tuton-RCJ/RCJ2026PCB/README.md

# RCJ2026PCB
PCBs for RoboCupJunior 2026 Maze
