tuton-RCJ/RCJ2026PCB/01-kanto/02-BOTTOM/02-BOTTOM.step

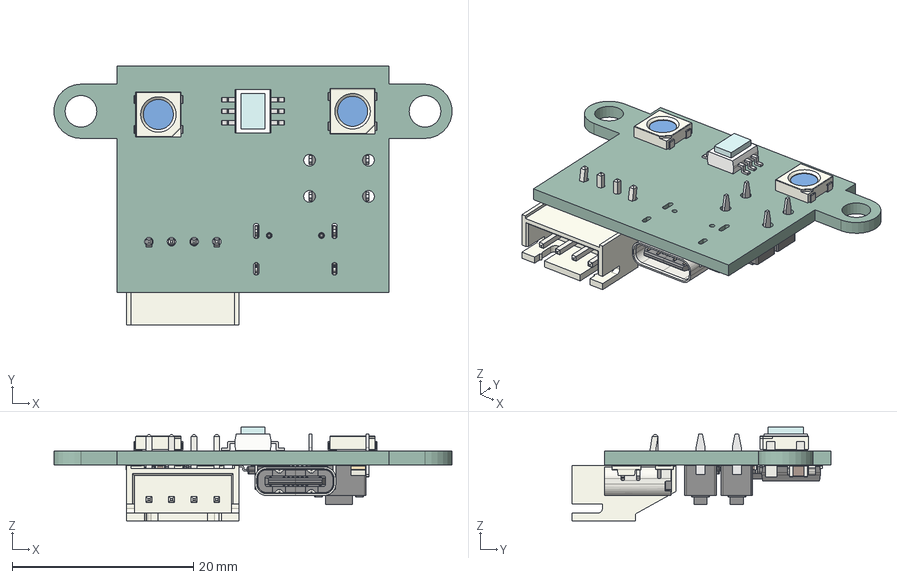
[picture p1: CAD file, 2025-10-03]
01-kanto/02-BOTTOM/02-BOTTOM.step
44.0 x 28.6 x 10.3 mm
LED_WS2812B_PLCC4_5.0x5.0mm_P3.2mm x 2
S9706 v1 v1
LQFP-48_7x7mm_P0.5mm
C_0402_1005Metric x 8
R_0805_2012Metric x 4
R_0402_1005Metric x 4
C_0805_2012Metric x 2
TVBP06_SW v2 x 2
MSOP-10_3x3mm_P0.5mm
C_0603_1608Metric
LED_1206_3216Metric x 2
JST_XH_S4B-XH-A_1x04_P2.50mm_Horizontal
USB_C_Receptacle_GCT_USB4105-xx-A_16P_TopMnt_Horizontal
SOT-223
02-BOTTOM_PCB
