tuton-RCJ/RCJ2026PCB/01-kanto/04-RPi/04-RPi.step

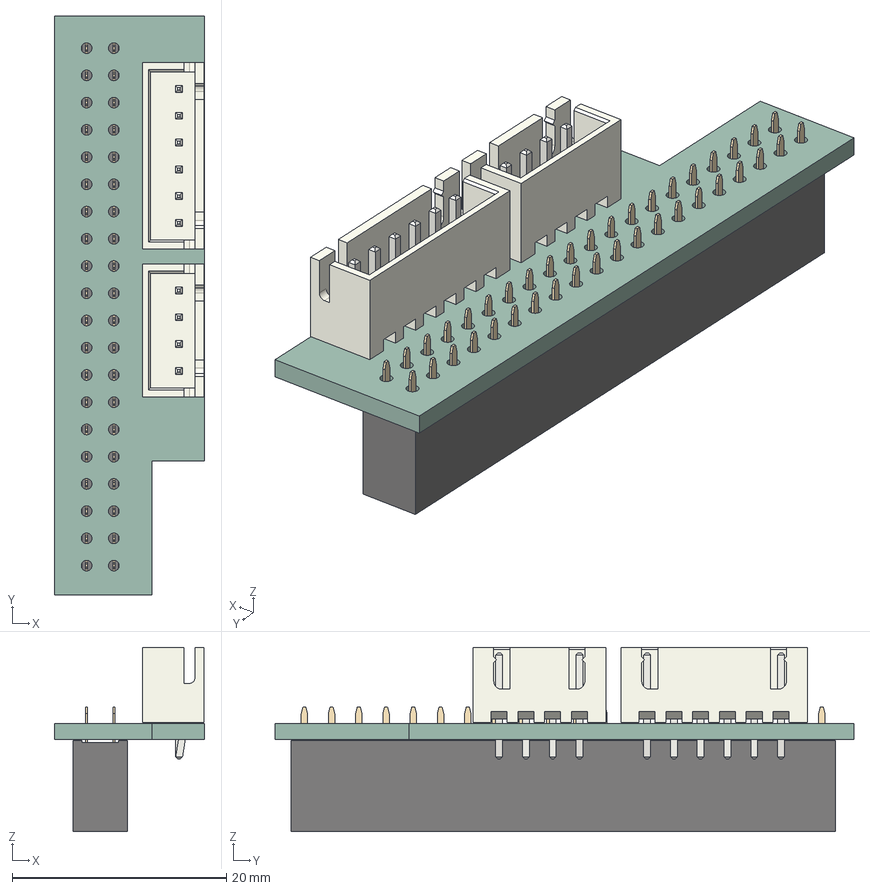
[picture p2: CAD file, 2025-10-18]
01-kanto/04-RPi/04-RPi.step
14.0 x 54.0 x 17.2 mm
JST_XH_B6B-XH-A_1x06_P2.50mm_Vertical
JST_XH_B4B-XH-A_1x04_P2.50mm_Vertical
PinSocket_2x20_P2.54mm_Vertical
04-RPi_PCB
