tuton-RCJ/RCJ2026PCB/01-kanto/04-RPi/04-RPi.kicad_pcb

## KiCad design 01-kanto/04-RPi/04-RPi.kicad_pcb (2025-10-18)

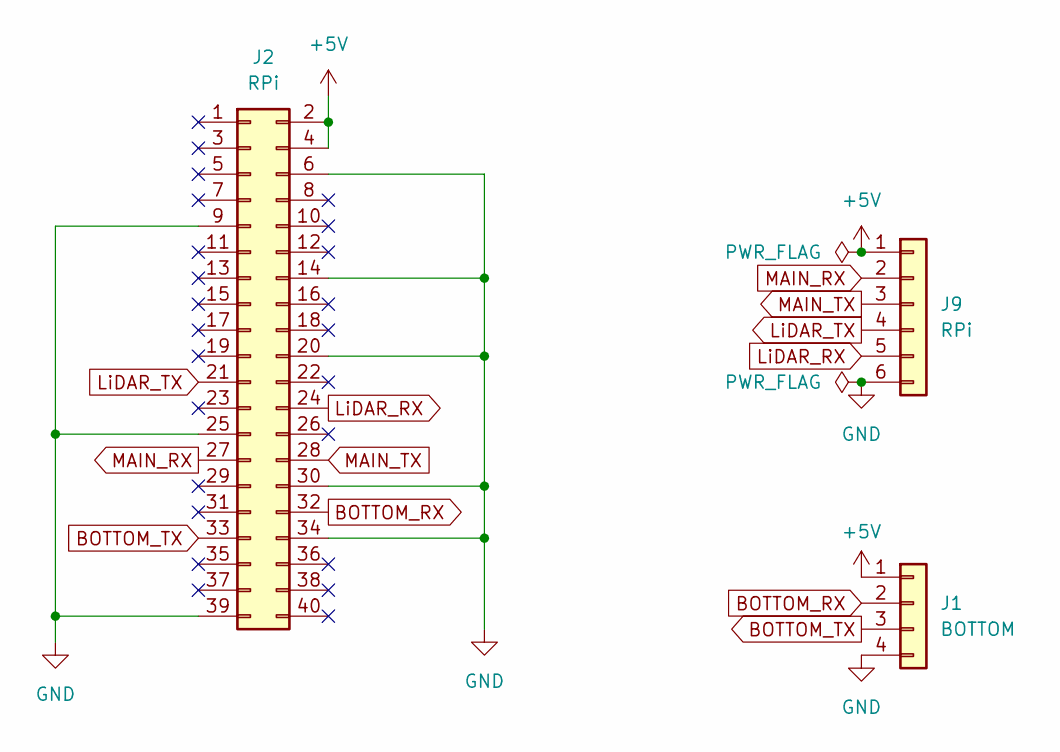
[picture p3: schematic 04-RPi.kicad_sch]

Parts:
J1: BOTTOM; JST_XH_B4B-XH-A_1x04_P2.50mm_Vertical
J2: RPi; PinSocket_2x20_P2.54mm_Vertical
J9: RPi; JST_XH_B6B-XH-A_1x06_P2.50mm_Vertical

Connections:
+5V: J1.1, J2.2, J2.4, J9.1
BOTTOM_RX: J1.2, J2.32
BOTTOM_TX: J1.3, J2.33
GND: J1.4, J2.6, J2.9, J2.14, J2.20, J2.25, J2.30, J2.34, J2.39, J9.6
LiDAR_RX: J2.24, J9.5
LiDAR_TX: J2.21, J9.4
MAIN_RX: J2.27, J9.2
MAIN_TX: J2.28, J9.3

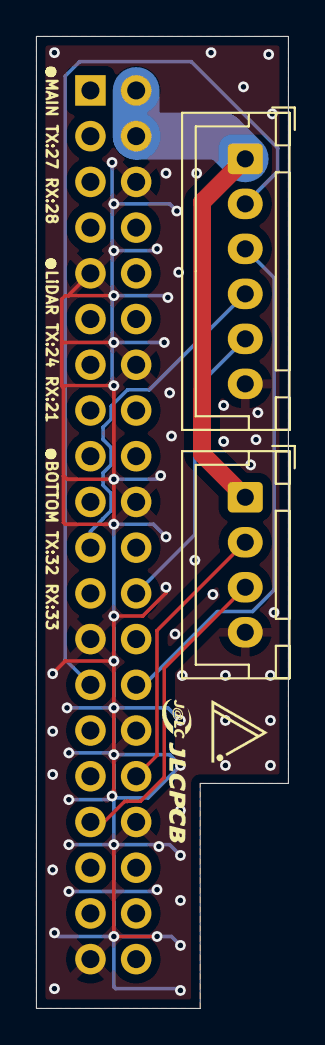
[picture p4: board 04-RPi.kicad_pcb from above]

Board: 2 copper layers, 14.0 x 54.0 mm, 3 parts (1 on the bottom side), 8 nets.
