tuton-RCJ/RCJ2026PCB/01-kanto/01-MAIN/01-MAIN.kicad_pcb

## KiCad design 01-kanto/01-MAIN/01-MAIN.kicad_pcb (2025-10-18)

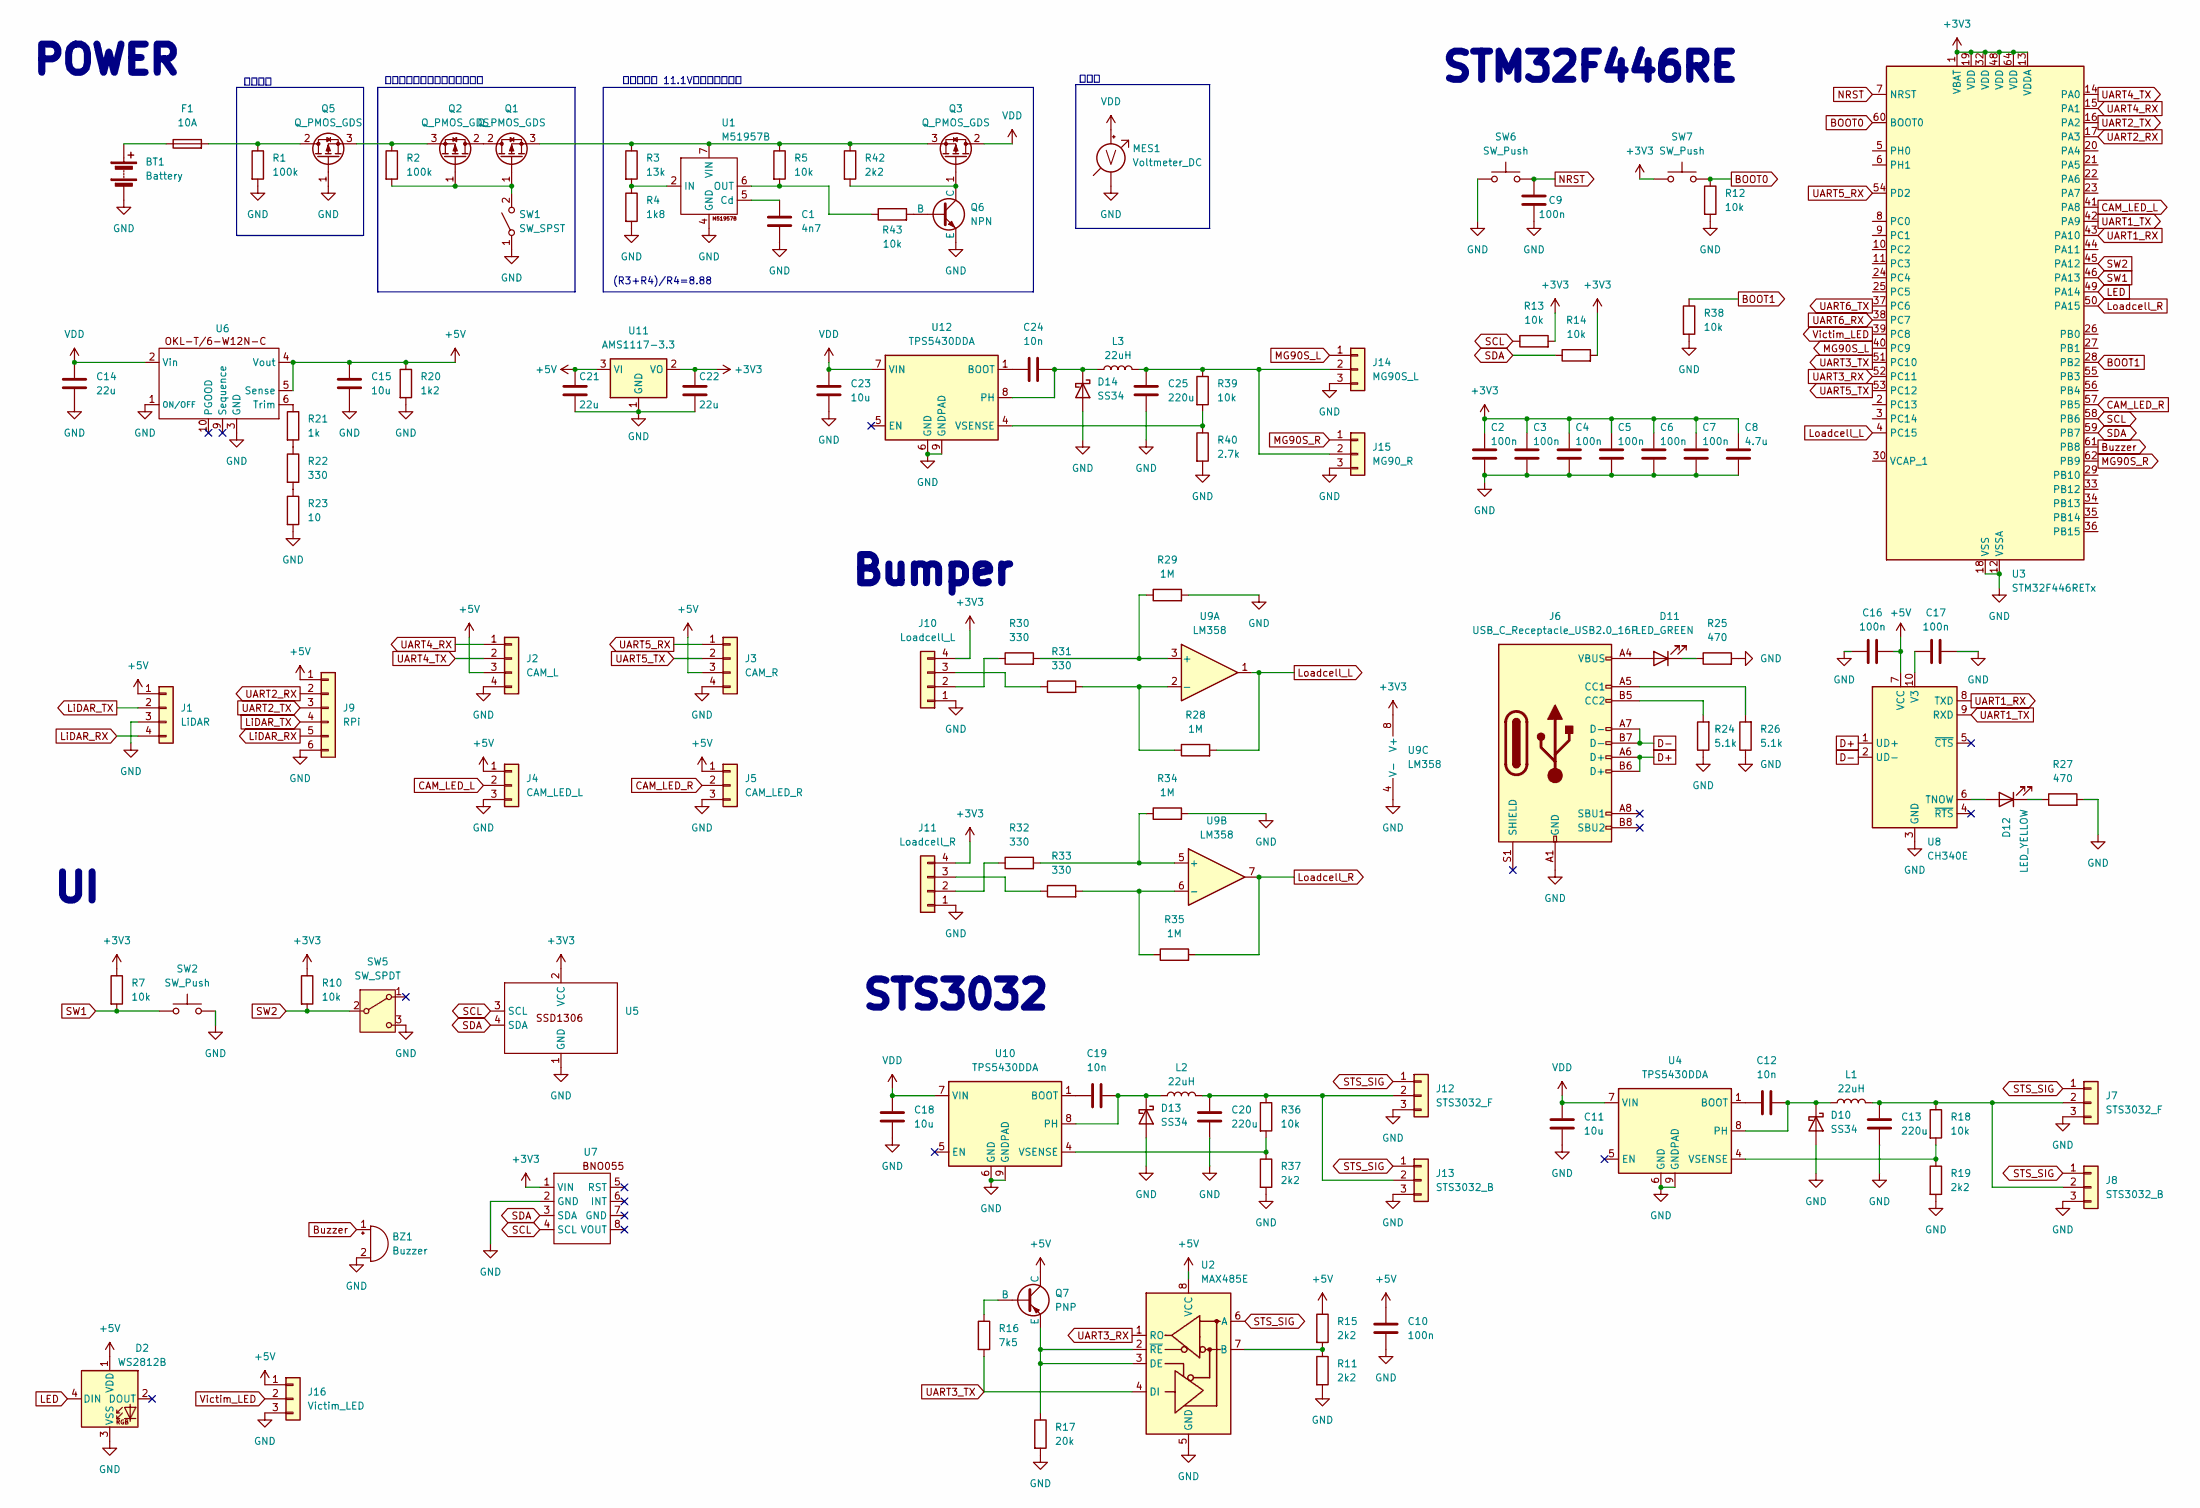
[picture p5: schematic 01-MAIN.kicad_sch]

Parts:
BT1: Battery; SolderWire-0.75sqmm_1x02_P7mm_D1.25mm_OD3.5mm
BZ1: Buzzer; Buzzer_TDK_PS1240P02BT_D12.2mm_H6.5mm
C1: 4n7; C_0402_1005Metric; LCSC C1538
C2, C3, C4, C5, C6, C7, C9, C10, C16, C17: 100n; C_0402_1005Metric; LCSC C1525
C8: 4.7u; C_0402_1005Metric; LCSC C23733
C11, C15, C18, C23: 10u; C_0805_2012Metric; LCSC C15850
C12, C19, C24: 10n; C_0402_1005Metric; LCSC C15195
C13, C20, C25: 220u; CP_Radial_D6.3mm_P2.50mm
C14, C21, C22: 22u; C_0805_2012Metric; LCSC C45783
D2: WS2812B; LED_WS2812B_PLCC4_5.0x5.0mm_P3.2mm
D10, D13, D14: SS34; D_SMA; LCSC C8678
D11: LED_GREEN; LED_0805_2012Metric; LCSC C2297
D12: LED_YELLOW; LED_0805_2012Metric; LCSC C2296
F1: 10A; FUSE_3557-15
J1: LiDAR; JST_PH_S4B-PH-K_1x04_P2.00mm_Horizontal
J2: CAM_L; Grove_1x04
J3: CAM_R; Grove_1x04
J4: CAM_LED_L; JST_PH_S3B-PH-K_1x03_P2.00mm_Horizontal
J5: CAM_LED_R; JST_PH_S3B-PH-K_1x03_P2.00mm_Horizontal
J6: USB_C_Receptacle_USB2.0_16P; USB_C_Receptacle_GCT_USB4105-xx-A_16P_TopMnt_Horizontal; LCSC C2765186
J7, J12: STS3032_F; Molex_SPOX_5268-03A_1x03_P2.50mm_Horizontal
J8, J13: STS3032_B; Molex_SPOX_5268-03A_1x03_P2.50mm_Horizontal
J9: RPi; JST_XH_B6B-XH-A_1x06_P2.50mm_Vertical
J10: Loadcell_L; JST_PH_S4B-PH-K_1x04_P2.00mm_Horizontal
J11: Loadcell_R; JST_PH_S4B-PH-K_1x04_P2.00mm_Horizontal
J14: MG90S_L; PinHeader_1x03_P2.54mm_Horizontal
J15: MG90_R; PinHeader_1x03_P2.54mm_Horizontal
J16: Victim_LED; JST_XH_B3B-XH-A_1x03_P2.50mm_Vertical
L1, L2, L3: 22uH; FXL1040-220-M; LCSC C177244
MES1: Voltmeter_DC; JST_XH_B2B-XH-A_1x02_P2.50mm_Vertical
Q1, Q2, Q3, Q5: Q_PMOS_GDS; TO-251-3_Vertical
Q6: NPN; SOT-23; LCSC C7420356
Q7: PNP; SOT-23; LCSC C41375129
R1, R2: 100k; R_0402_1005Metric; LCSC C25741
R3: 13k; R_0603_1608Metric; LCSC C22797
R4: 1k8; R_0603_1608Metric; LCSC C4177
R5, R7, R10, R12, R13, R14, R18, R36, R38, R39, R43: 10k; R_0402_1005Metric; LCSC C25744
R11, R15, R19, R37, R42: 2k2; R_0402_1005Metric; LCSC C25879
R16: 7k5; R_0603_1608Metric; LCSC C23234
R17: 20k; R_0402_1005Metric; LCSC C25765
R20: 1k2; R_0603_1608Metric; LCSC C22765
R21: 1k; R_0402_1005Metric; LCSC C11702
R22, R30, R31, R32, R33: 330; R_0402_1005Metric; LCSC C25104
R23: 10; R_0402_1005Metric; LCSC C25077
R24, R26: 5.1k; R_0402_1005Metric; LCSC C25905
R25, R27: 470; R_0603_1608Metric; LCSC C23179
R28, R29, R34, R35: 1M; R_0402_1005Metric; LCSC C26083
R40: 2.7k; R_0603_1608Metric; LCSC C13167
SW1: SW_SPST; AkizukiSmallRockerSwitchHorizontal
SW2, SW6, SW7: SW_Push; SW_PUSH_6mm
SW5: SW_SPDT; Akizuki_3PSW
U1: M51957B
U2: MAX485E; SOIC-8_3.9x4.9mm_P1.27mm
U3: STM32F446RETx; LQFP-64_10x10mm_P0.5mm
U4, U10, U12: TPS5430DDA; TI_SO-PowerPAD-8_ThermalVias; LCSC C9864
U5: SSD1306
U6: OKL-T/6-W12N-C; OKL-T6-W12N-C-SMD
U7: BNO055
U8: CH340E; MSOP-10_3x3mm_P0.5mm; LCSC C99652
U9: LM358; SOIC-8-1EP_3.9x4.9mm_P1.27mm_EP2.29x3mm; LCSC C7950
U11: AMS1117-3.3; SOT-223-3_TabPin2; LCSC C6186

Connections:
+3V3: C2.1, C3.1, C4.1, C5.1, C6.1, C7.1, C8.1, C22.1, J10.4, J11.4, R7.1, R10.1, R13.2, R14.2, SW7.1, U3.1 (VBAT), U3.13 (VDDA), U3.19 (VDD), U3.32 (VDD), U3.48 (VDD), U3.64 (VDD), U5.2 (VCC), U7.1 (VIN), U9.8 (V+), U11.2 (VO)
+5V: C10.2, C15.1, C16.2, C21.1, D2.1 (VDD), J1.1, J2.3, J3.3, J4.1, J5.1, J9.1, J16.1, Q7.1 (C), R15.1, R20.1, U2.8 (VCC), U6.4 (Vout), U6.5 (Sense), U8.7 (VCC), U11.3 (VI)
BOOT0: R12.1, SW7.2, U3.60 (BOOT0)
BOOT1: R38.1, U3.28 (PB2)
Buzzer: BZ1.1 (+), U3.61 (PB8)
CAM_LED_L: J4.2, U3.41 (PA8)
CAM_LED_R: J5.2, U3.57 (PB5)
D+: J6.A6 (D+), J6.B6 (D+), U8.1 (UD+)
D-: J6.A7 (D-), J6.B7 (D-), U8.2 (UD-)
GND: BT1.2 (-), BZ1.2 (-), C1.2, C2.2, C3.2, C4.2, C5.2, C6.2, C7.2, C8.2, C9.2, C10.1, C11.2, C13.2, C14.2, C15.2, C16.1, C17.2, C18.2, C20.2, C21.2, C22.2, C23.2, C25.2, D2.3 (VSS), D10.2 (A), D13.2 (A), D14.2 (A), J1.3, J2.4, J3.4, J4.3, J5.3, J6.A1 (GND), J6.A12 (GND), J6.B1 (GND), J6.B12 (GND), J7.3, J8.3, J9.6, J10.1, J11.1, J12.3, J13.3, J14.3, J15.3, J16.3, MES1.1 (-), Q5.1 (G), Q6.3 (E), R1.2, R4.2, R11.2, R12.2, R17.2, R19.2, R20.2, R23.2, R24.1, R25.2, R26.1, R27.2, R29.2, R34.2, R37.2, R38.2, R40.2, SW1.1 (A), SW2.2, SW5.3 (C), SW6.1, U1.4 (GND), U2.5 (GND), U3.12 (VSSA), U3.18 (VSS), U3.31 (VSS), U3.47 (VSS), U3.63 (VSS), U4.6 (GND), U4.9 (GNDPAD), U5.1 (GND), U6.1 (ON/OFF), U6.3 (GND), U6.7 (GND), U7.2 (GND), U8.3 (GND), U9.4 (V-), U10.6 (GND), U10.9 (GNDPAD), U11.1 (GND), U12.6 (GND), U12.9 (GNDPAD)
LED: D2.4 (DIN), U3.49 (PA14)
LiDAR_RX: J1.4, J9.5
LiDAR_TX: J1.2, J9.4
Loadcell_L: R28.2, U3.4 (PC15), U9.1
Loadcell_R: R35.2, U3.50 (PA15), U9.7
MG90S_L: J14.1, U3.40 (PC9)
MG90S_R: J15.1, U3.62 (PB9)
NRST: C9.1, SW6.2, U3.7 (NRST)
unnamed: BT1.1 (+), F1.1
unnamed: C12.2, D10.1 (K), L1.1, U4.8 (PH)
unnamed: D11.2 (A), J6.A4 (VBUS), J6.A9 (VBUS), J6.B4 (VBUS), J6.B9 (VBUS)
unnamed: D11.1 (K), R25.1
unnamed: D12.2 (A), U8.6 (TNOW)
unnamed: D12.1 (K), R27.1
unnamed: C19.2, D13.1 (K), L2.1, U10.8 (PH)
unnamed: C24.2, D14.1 (K), L3.1, U12.8 (PH)
unnamed: J6.A5 (CC1), R26.2
unnamed: J6.B5 (CC2), R24.2
unnamed: C13.1, J7.2, J8.2, L1.2, R18.1
unnamed: J10.2, R30.1
unnamed: J10.3, R31.1
unnamed: J11.2, R32.1
unnamed: J11.3, R33.1
unnamed: C20.1, J12.2, J13.2, L2.2, R36.1
unnamed: C25.1, J14.2, J15.2, L3.2, R39.1
unnamed: Q1.2 (D), Q2.2 (D)
unnamed: Q1.1 (G), Q2.1 (G), R2.2, SW1.2 (B)
unnamed: Q1.3 (S), Q3.3 (S), R3.1, R5.1, R42.1, U1.7 (VIN)
unnamed: Q2.3 (S), Q5.3 (S), R2.1
unnamed: Q3.1 (G), Q6.1 (C), R42.2
unnamed: F1.2, Q5.2 (D), R1.1
unnamed: Q6.2 (B), R43.2
unnamed: Q7.2 (B), R16.1
unnamed: Q7.3 (E), R17.1, U2.2 (~RE), U2.3 (DE)
unnamed: R21.2, R22.1
unnamed: R22.2, R23.1
unnamed: C1.1, U1.5 (Cd)
unnamed: R3.2, R4.1, U1.2 (IN)
unnamed: R5.2, R43.1, U1.6 (OUT)
unnamed: R11.1, R15.2, U2.7 (B)
unnamed: C12.1, U4.1 (BOOT)
unnamed: R18.2, R19.1, U4.4 (VSENSE)
unnamed: R21.1, U6.6 (Trim)
unnamed: C17.1, U8.10 (V3)
unnamed: R29.1, R30.2, U9.3 (+)
unnamed: R28.1, R31.2, U9.2 (-)
unnamed: R32.2, R34.1, U9.5 (+)
unnamed: R33.2, R35.1, U9.6 (-)
unnamed: C19.1, U10.1 (BOOT)
unnamed: R36.2, R37.1, U10.4 (VSENSE)
unnamed: C24.1, U12.1 (BOOT)
unnamed: R39.2, R40.1, U12.4 (VSENSE)
SCL: R13.1, U3.58 (PB6), U5.3 (SCL), U7.4 (SCL)
SDA: R14.1, U3.59 (PB7), U5.4 (SDA), U7.3 (SDA)
STS_SIG: J7.1, J8.1, J12.1, J13.1, U2.6 (A)
SW1: R7.2, SW2.1, U3.46 (PA13)
SW2: R10.2, SW5.2 (B), U3.45 (PA12)
UART1_RX: U3.43 (PA10), U8.8 (TXD)
UART1_TX: U3.42 (PA9), U8.9 (RXD)
UART2_RX: J9.2, U3.17 (PA3)
UART2_TX: J9.3, U3.16 (PA2)
UART3_RX: U2.1 (RO), U3.52 (PC11)
UART3_TX: R16.2, U2.4 (DI), U3.51 (PC10)
UART4_RX: J2.1, U3.15 (PA1)
UART4_TX: J2.2, U3.14 (PA0)
UART5_RX: J3.1, U3.54 (PD2)
UART5_TX: J3.2, U3.53 (PC12)
UART6_RX: U3.38 (PC7)
UART6_TX: U3.37 (PC6)
VDD: C11.1, C14.1, C18.1, C23.1, MES1.2 (+), Q3.2 (D), U4.7 (VIN), U6.2 (Vin), U10.7 (VIN), U12.7 (VIN)
Victim_LED: J16.2, U3.39 (PC8)

Notes on the sheet:
POWER
STM32F446RE
ハイサイドスイッチ＆逆流保護
STS3032
(R3+R4)/R4=8.88
低電圧防止 11.1V以下で強制遮断
Bumper
電圧計
逆接保護

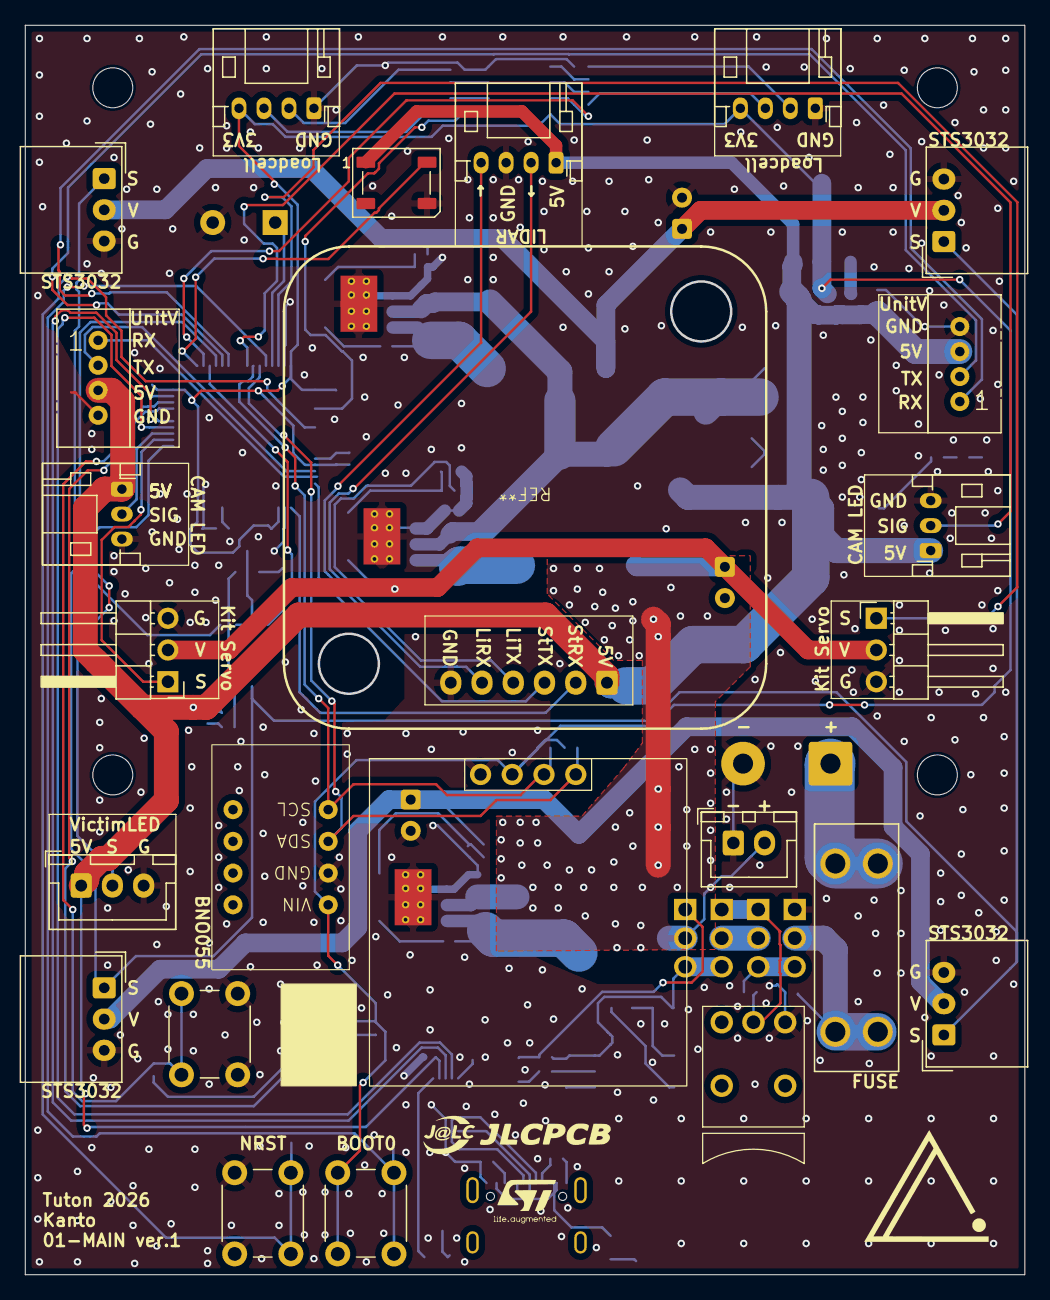
[picture p6: board 01-MAIN.kicad_pcb from above]

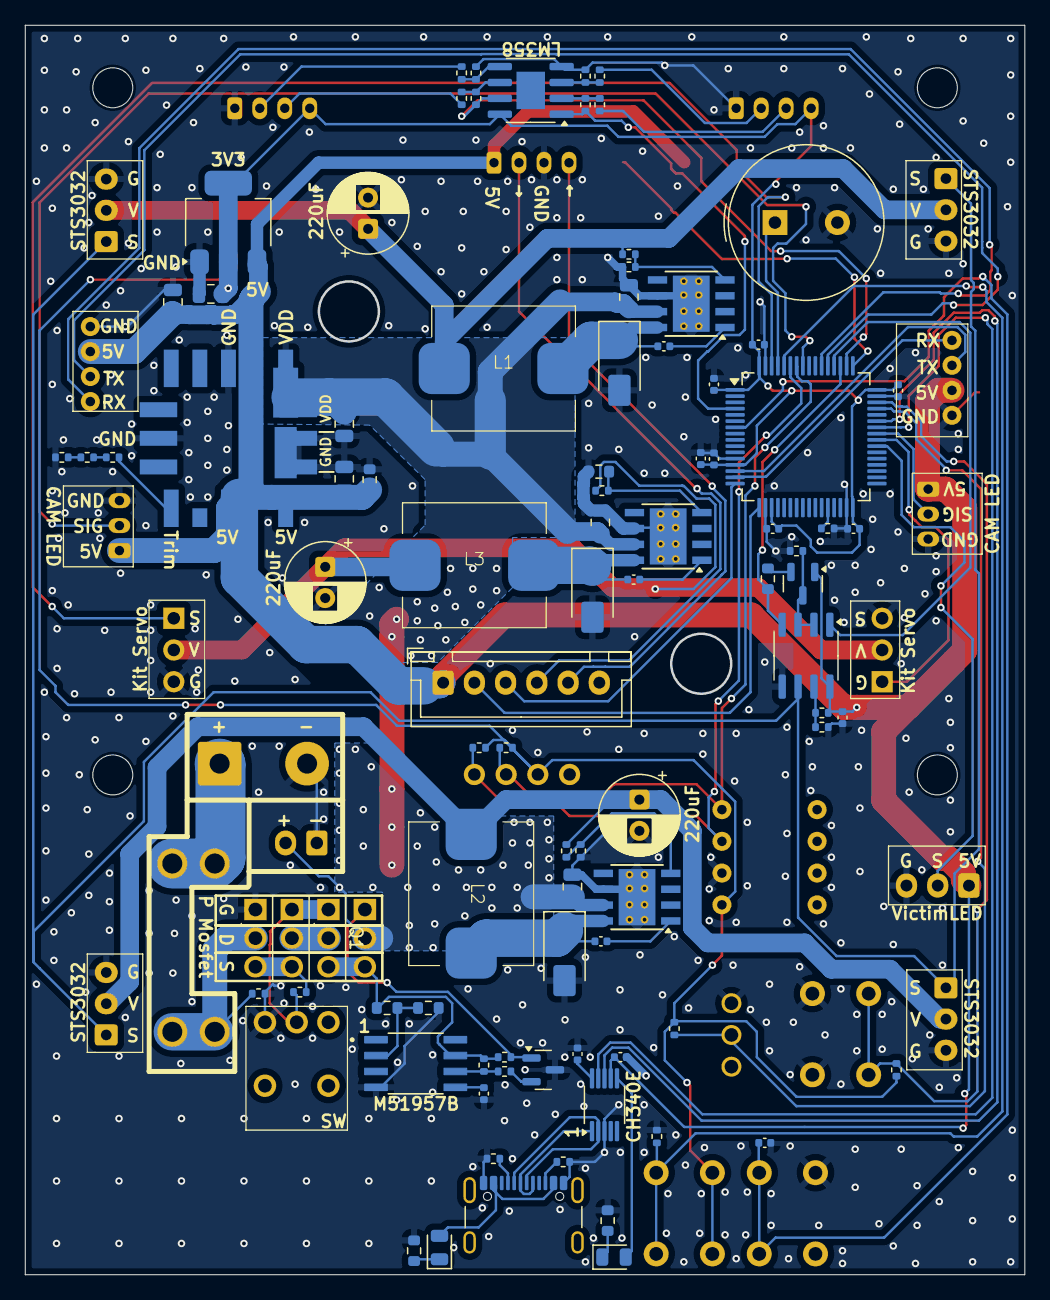
[picture p7: board 01-MAIN.kicad_pcb from below]

Board: 2 copper layers, 80.0 x 100.0 mm, 116 parts (91 on the bottom side), 79 nets.
