tuton-RCJ/RCJ2026PCB/01-kanto/02-BOTTOM/02-BOTTOM.kicad_pcb

## KiCad design 01-kanto/02-BOTTOM/02-BOTTOM.kicad_pcb (2025-10-18)

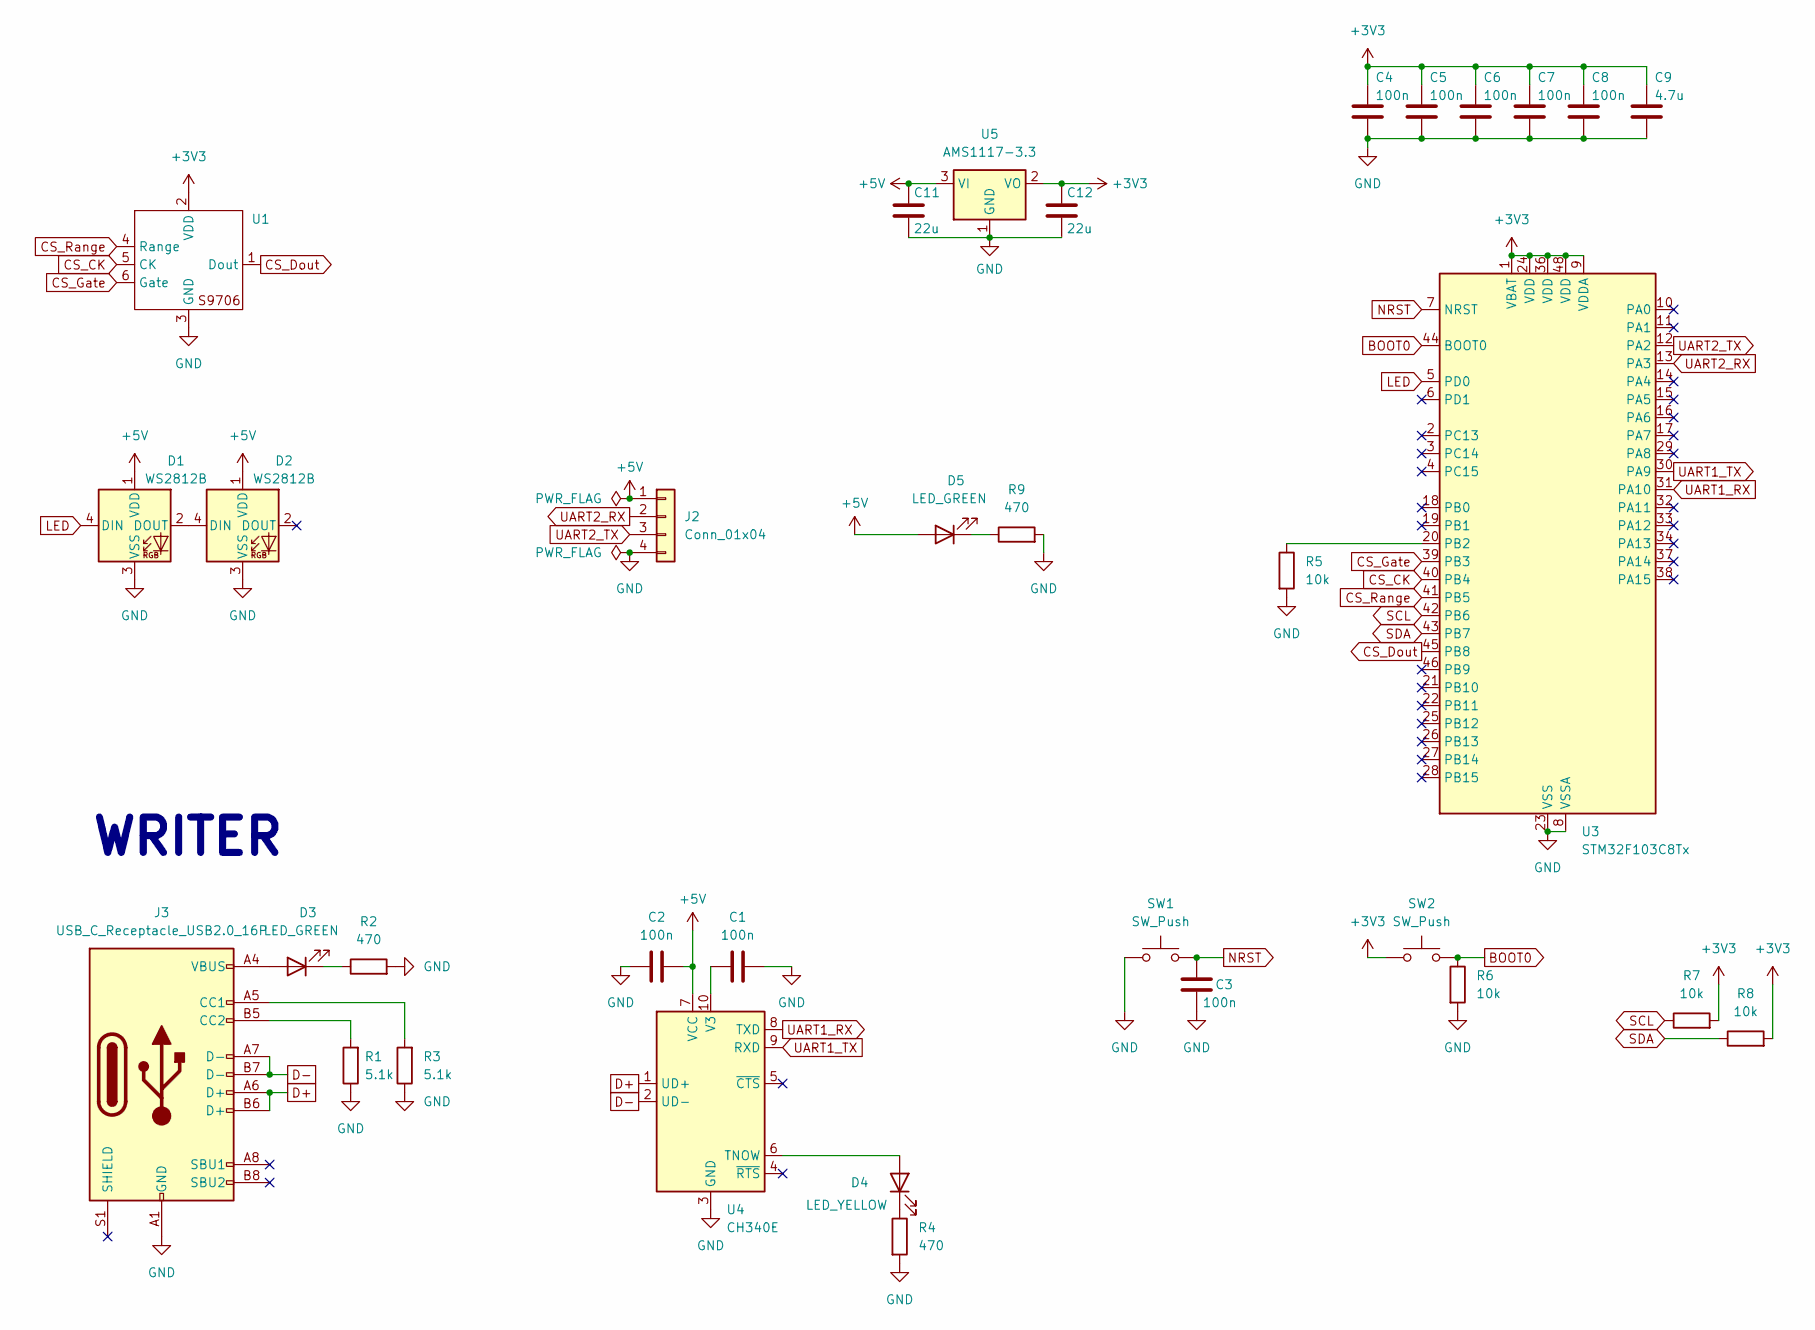
[picture p8: schematic 02-BOTTOM.kicad_sch]

Parts:
C1, C2, C3, C4, C5, C6, C7, C8: 100n; C_0402_1005Metric; LCSC C1525
C9: 4.7u; C_0603_1608Metric; LCSC C19666
C11, C12: 22u; C_0805_2012Metric; LCSC C45783
D1, D2: WS2812B; LED_WS2812B_PLCC4_5.0x5.0mm_P3.2mm
D3, D5: LED_GREEN; LED_0805_2012Metric; LCSC C2297
D4: LED_YELLOW; LED_0805_2012Metric; LCSC C2296
J2: Conn_01x04; JST_XH_S4B-XH-A_1x04_P2.50mm_Horizontal
J3: USB_C_Receptacle_USB2.0_16P; USB_C_Receptacle_GCT_USB4105-xx-A_16P_TopMnt_Horizontal; LCSC C2765186
R1, R3: 5.1k; R_0402_1005Metric; LCSC C25905
R2, R4, R9: 470; R_0603_1608Metric; LCSC C23179
R5, R6, R7, R8: 10k; R_0402_1005Metric; LCSC C25744
SW1, SW2: SW_Push; TVBP06_SW
U1: S9706
U3: STM32F103C8Tx; LQFP-48_7x7mm_P0.5mm; LCSC C8734
U4: CH340E; MSOP-10_3x3mm_P0.5mm; LCSC C99652
U5: AMS1117-3.3; SOT-223-3_TabPin2; LCSC C6186

Connections:
+3V3: C4.1, C5.1, C6.1, C7.1, C8.1, C9.1, C12.1, R7.2, R8.2, SW2.1, U1.2 (VDD), U3.1 (VBAT), U3.9 (VDDA), U3.24 (VDD), U3.36 (VDD), U3.48 (VDD), U5.2 (VO)
+5V: C2.2, C11.1, D1.1 (VDD), D2.1 (VDD), D5.2 (A), J2.1, U4.7 (VCC), U5.3 (VI)
BOOT0: R6.1, SW2.2, U3.44 (BOOT0)
CS_CK: U1.5 (CK), U3.40 (PB4)
CS_Dout: U1.1 (Dout), U3.45 (PB8)
CS_Gate: U1.6 (Gate), U3.39 (PB3)
CS_Range: U1.4 (Range), U3.41 (PB5)
D+: J3.A6 (D+), J3.B6 (D+), U4.1 (UD+)
D-: J3.A7 (D-), J3.B7 (D-), U4.2 (UD-)
GND: C1.2, C2.1, C3.2, C4.2, C5.2, C6.2, C7.2, C8.2, C9.2, C11.2, C12.2, D1.3 (VSS), D2.3 (VSS), J2.4, J3.A1 (GND), J3.A12 (GND), J3.B1 (GND), J3.B12 (GND), R1.1, R2.2, R3.1, R4.2, R5.2, R6.2, R9.2, SW1.1, U1.3 (GND), U3.8 (VSSA), U3.23 (VSS), U3.35 (VSS), U3.47 (VSS), U4.3 (GND), U5.1 (GND)
LED: D1.4 (DIN), U3.5 (PD0)
NRST: C3.1, SW1.2, U3.7 (NRST)
unnamed: D1.2 (DOUT), D2.4 (DIN)
unnamed: D3.2 (A), J3.A4 (VBUS), J3.A9 (VBUS), J3.B4 (VBUS), J3.B9 (VBUS)
unnamed: D3.1 (K), R2.1
unnamed: D4.2 (A), U4.6 (TNOW)
unnamed: D4.1 (K), R4.1
unnamed: D5.1 (K), R9.1
unnamed: J3.A5 (CC1), R3.2
unnamed: J3.B5 (CC2), R1.2
unnamed: R5.1, U3.20 (PB2)
unnamed: C1.1, U4.10 (V3)
SCL: R7.1, U3.42 (PB6)
SDA: R8.1, U3.43 (PB7)
UART1_RX: U3.31 (PA10), U4.8 (TXD)
UART1_TX: U3.30 (PA9), U4.9 (RXD)
UART2_RX: J2.2, U3.13 (PA3)
UART2_TX: J2.3, U3.12 (PA2)

Notes on the sheet:
WRITER

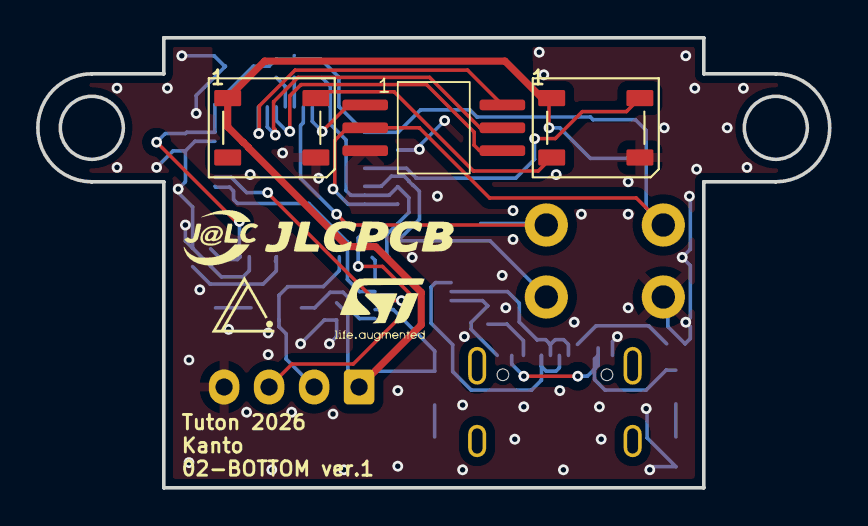
[picture p9: board 02-BOTTOM.kicad_pcb from above]

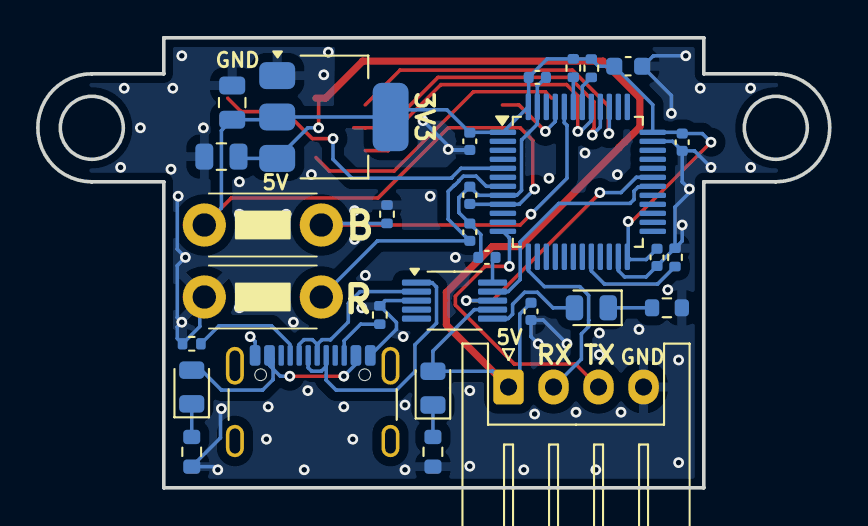
[picture p10: board 02-BOTTOM.kicad_pcb from below]

Board: 2 copper layers, 44.0 x 25.0 mm, 33 parts (30 on the bottom side), 28 nets.
