tuton-RCJ/RCJ2026PCB/01-kanto/pin/01-MAIN/01-MAIN.ioc

Mcu.UserName=STM32F446RETx
PA0-WKUP.Signal=UART4_TX
PA1.Signal=UART4_RX
PA10.Signal=USART1_RX
PA12.Signal=GPIO_Input
PA13.Signal=GPIO_Input
PA14.Signal=GPIO_Output
PA15.Signal=GPXTI15
PA2.Signal=USART2_TX
PA3.Signal=USART2_RX
PA8.Signal=GPIO_Output
PA9.Signal=USART1_TX
PB5.Signal=GPIO_Output
PB6.Signal=I2C1_SCL
PB7.Signal=I2C1_SDA
PB9.Signal=S_TIM11_CH1
PC10.Signal=USART3_TX
PC11.Signal=USART3_RX
PC12.Signal=UART5_TX
PC6.Signal=USART6_TX
PC7.Signal=USART6_RX
PC8.Signal=GPIO_Output
PC9.Signal=S_TIM3_CH4
PD2.Signal=UART5_RX
