tuton-RCJ/RCJ2026PCB/(commit log)

2025-09-24 03-PWR 逆接防止・スイッチ・逆流防止
    [01-MAIN.kicad_pcb, 01-MAIN.kicad_sch, 02-BOTTOM.kicad_pcb, 02-BOTTOM.kicad_sch, 03-PWR.kicad_pcb, 03-PWR.kicad_sch, 04-UI.kicad_pcb, 04-UI.kicad_sch]
2025-09-25 integrated ui with pwr
    [03-PWR.kicad_sch, 04-UI.kicad_pcb, 04-UI.kicad_sch]
2025-09-27 基板は2枚だけさ
    [01-MAIN.kicad_sch, 02-BOTTOM.kicad_sch]
2025-10-02 02-BOTTOM schematic completed
    [02-BOTTOM.kicad_pcb, 02-BOTTOM.kicad_sch]
2025-10-03 02-BOTTOM placed parts
    [02-BOTTOM.kicad_pcb, 02-BOTTOM.kicad_sch, 02-BOTTOM.step, 03-PWR.kicad_pcb, 03-PWR.kicad_sch]
2025-10-05 02-BOTTOM PCBdesign completed
    [01-MAIN.kicad_sch, 02-BOTTOM.kicad_pcb, 02-BOTTOM.kicad_sch, bom.csv, designators.csv, positions.csv]
2025-10-12 フットプリント途中
    [01-MAIN.kicad_pcb, 01-MAIN.kicad_sch]
2025-10-14 配置した
    [01-MAIN.kicad_pcb, 01-MAIN.kicad_sch, bom.csv, designators.csv, positions.csv]
2025-10-18 01-MAIN, 02-BOTTOM, 04-RPi totally completed
    [01-MAIN.kicad_pcb, 01-MAIN.kicad_sch, 02-BOTTOM.kicad_pcb, 02-BOTTOM.kicad_sch, 03-CAM.kicad_pcb, 03-CAM.kicad_sch, 04-RPi.kicad_pcb, 04-RPi.kicad_sch]
